harry48225/Octoscale/hardware/case.FCStd

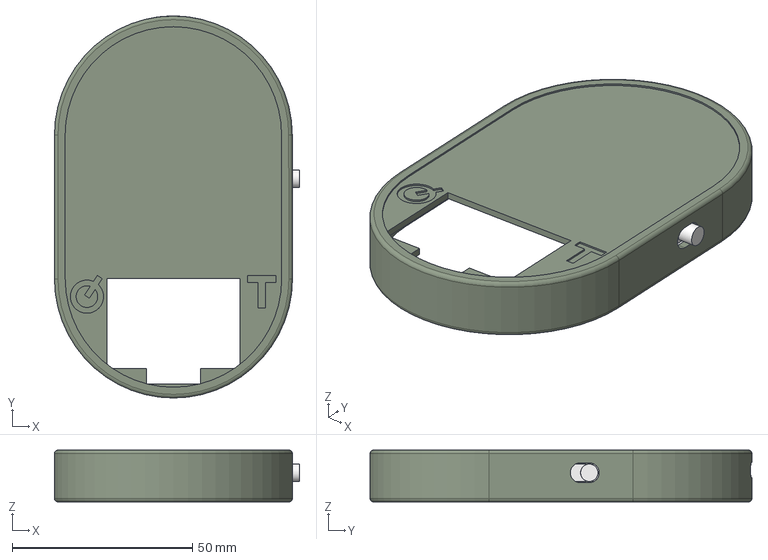
[picture p1: CAD file, 2022-09-23]
hardware/case.FCStd
68.0 x 106.0 x 14.4 mm
Case top
Slider
