harry48225/Octoscale/hardware/type-c-31-m-12-1.snapshot.5/HRO_TYPE-C-31-M-12.step

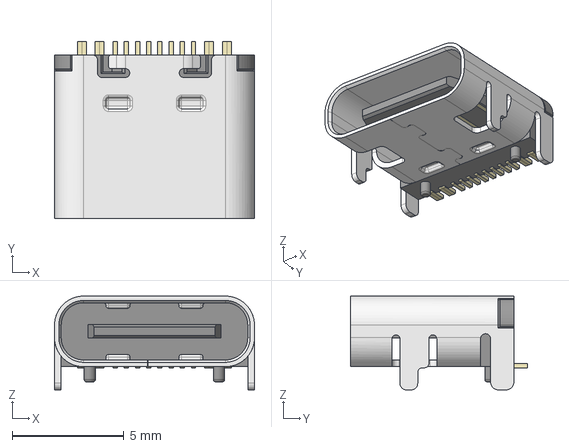
[picture p2: CAD file, 2022-06-12]
hardware/type-c-31-m-12-1.snapshot.5/HRO_TYPE-C-31-M-12.step
8.95 x 7.90 x 4.20 mm
