harry48225/Octoscale/hardware/500g load cell.FCStd

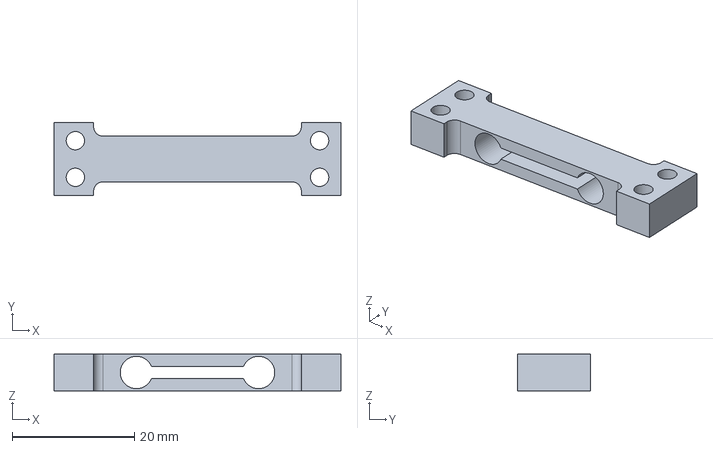
[picture p3: CAD file, 2022-06-10]
hardware/500g load cell.FCStd
47.0 x 12.0 x 6.00 mm
