harry48225/Octoscale/hardware/Battery pack.FCStd

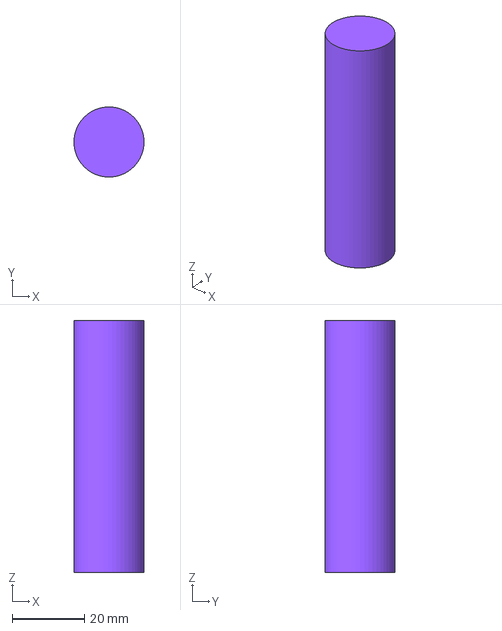
[picture p4: CAD file, 2022-06-09]
hardware/Battery pack.FCStd
19.5 x 19.5 x 70.0 mm
