harry48225/Octoscale/hardware/load cell-Body.step

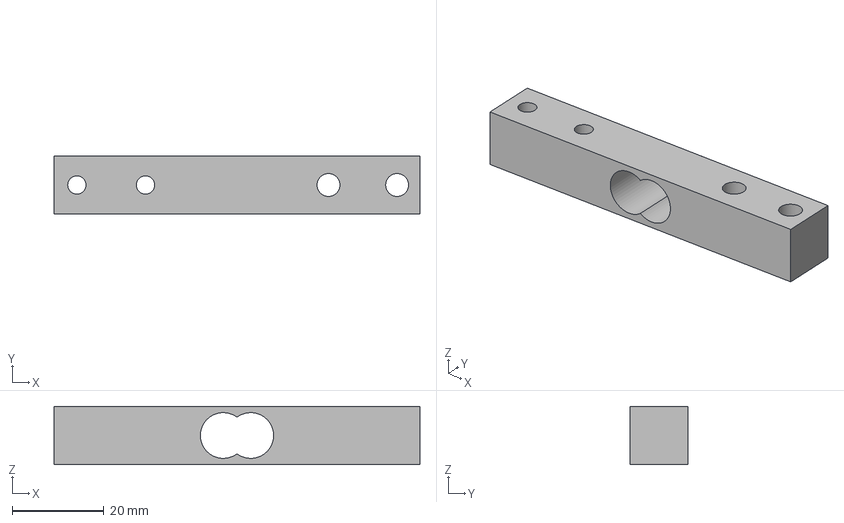
[picture p5: CAD file, 2022-06-09]
hardware/load cell-Body.step
80.0 x 12.7 x 12.7 mm
