harry48225/Octoscale/(list of files, cad)

Other CAD files:
hardware/Battery pack-Battery.step
hardware/load cell.FCStd
