harry48225/Octoscale/pcb/octoscale.kicad_pcb

## KiCad design pcb/octoscale.kicad_pcb (2022-11-08)

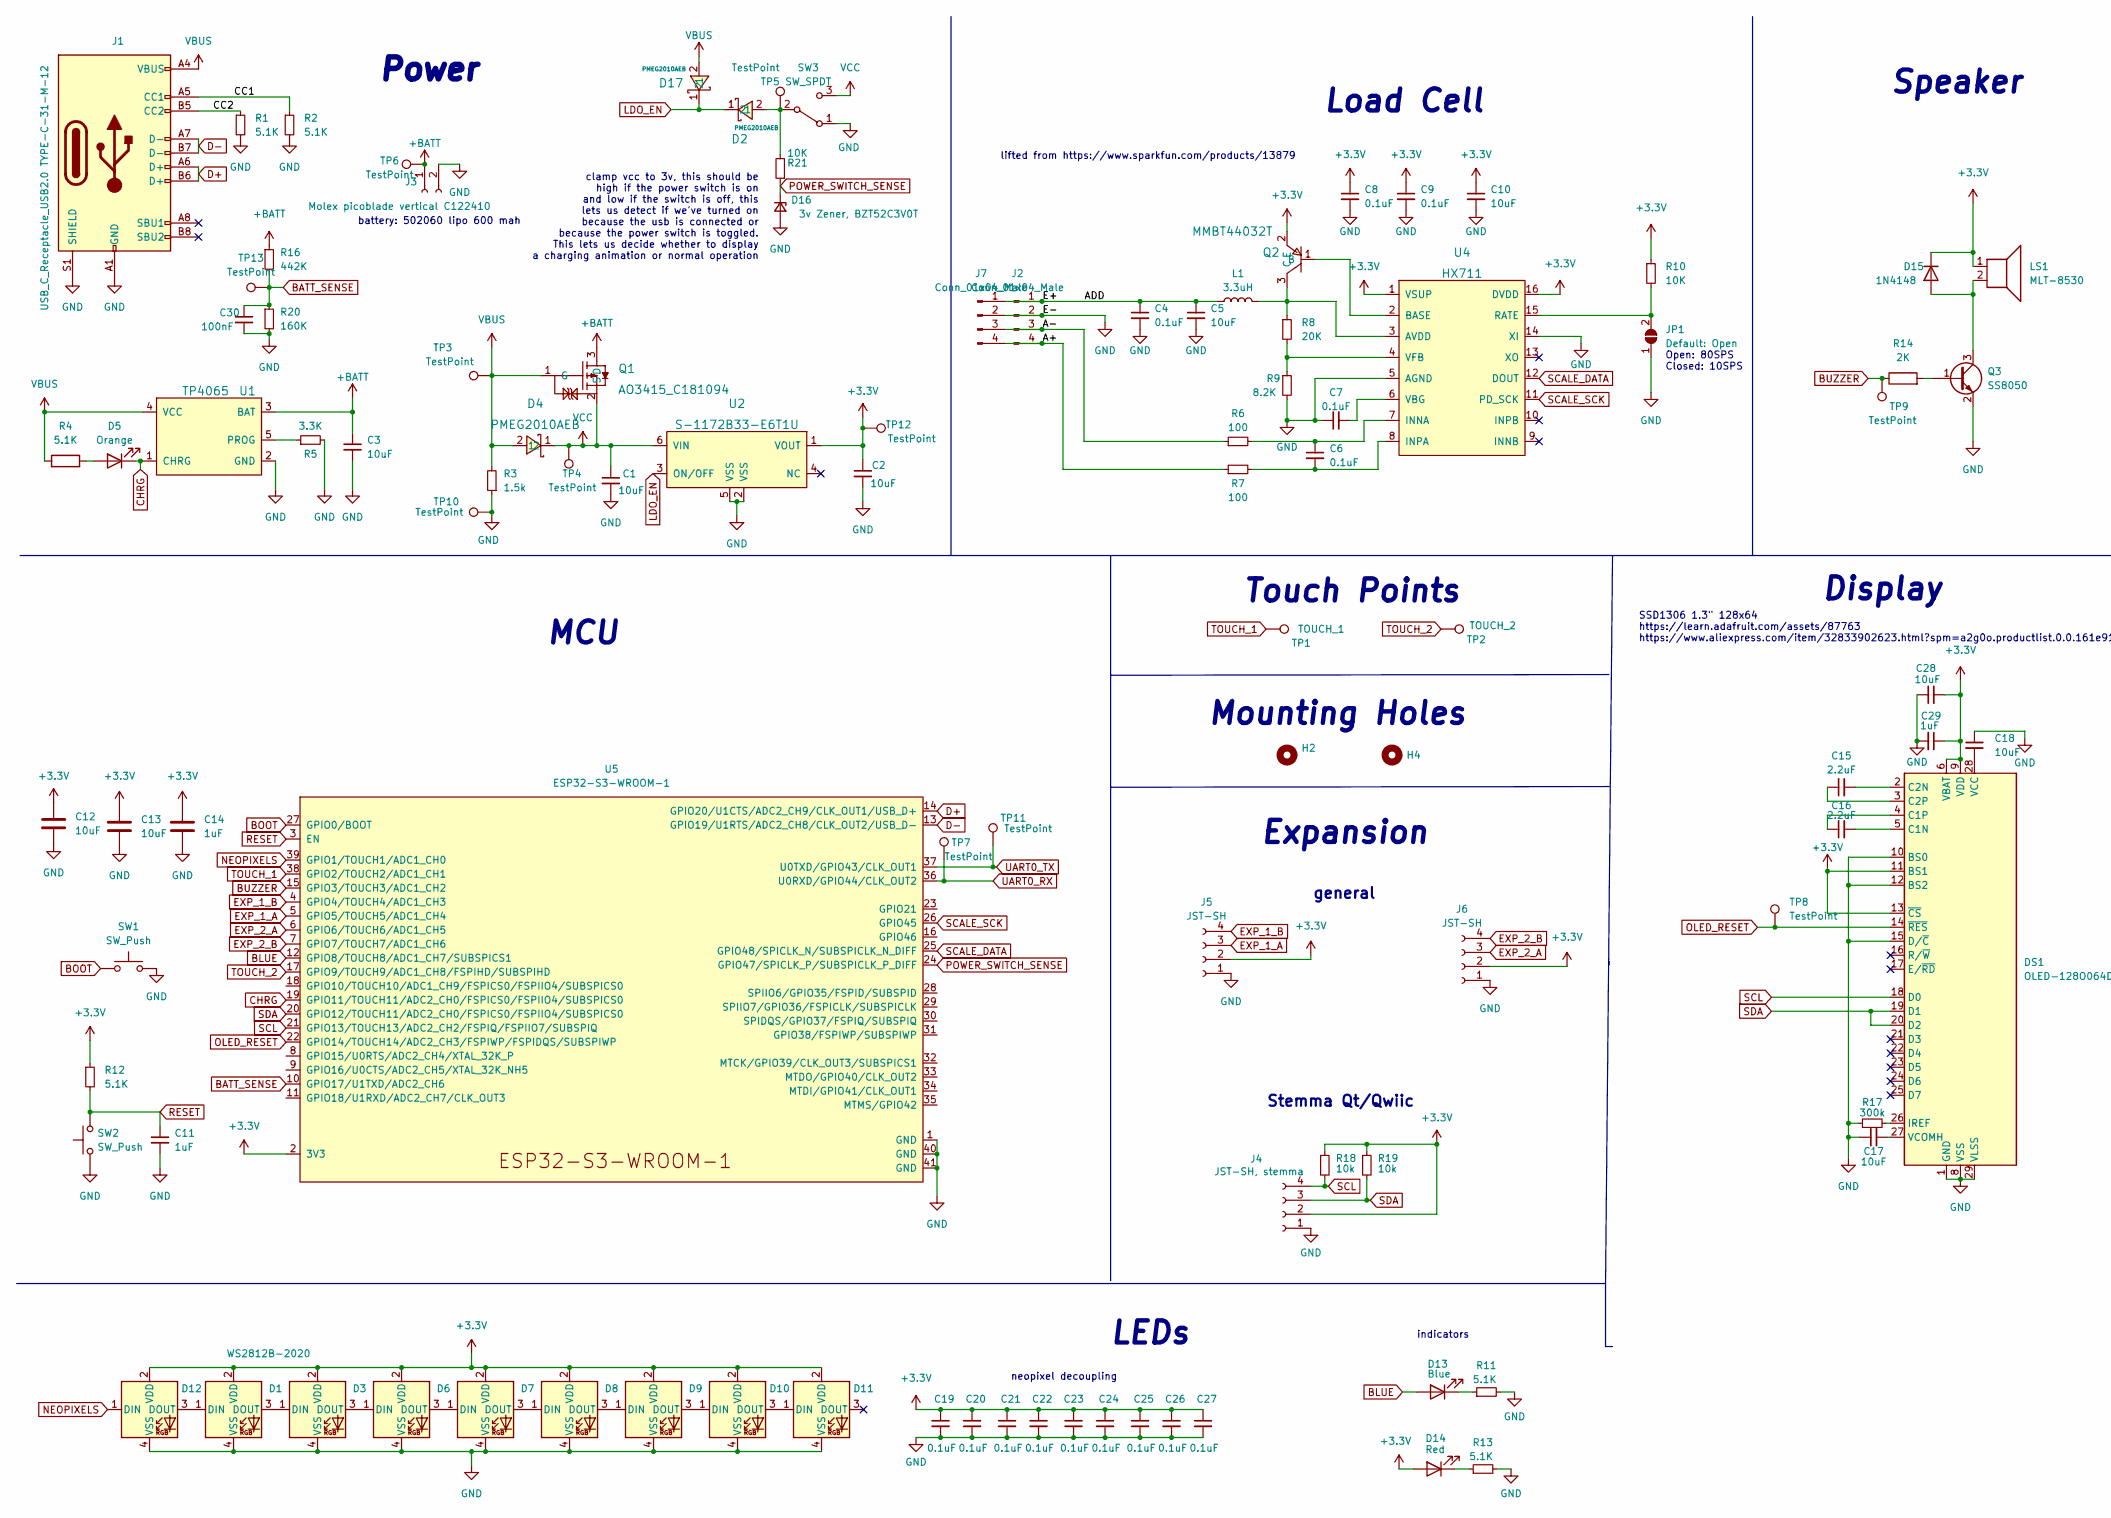
[picture p6: schematic octoscale.kicad_sch, part in row 1, column 1]

Parts:
C1, C2, C3, C5, C10, C12, C13, C17, C18, C28: 10uF; C_0805_2012Metric_Pad1.18x1.45mm_HandSolder
C4, C6, C7, C8, C9, C19, C20, C21, C22, C23, C24, C25, C26, C27: 0.1uF; C_0805_2012Metric_Pad1.18x1.45mm_HandSolder
C11, C14, C29: 1uF; C_0805_2012Metric_Pad1.18x1.45mm_HandSolder
C15, C16: 2.2uF; C_0805_2012Metric_Pad1.18x1.45mm_HandSolder
C30: 100nF; C_0805_2012Metric_Pad1.18x1.45mm_HandSolder
D1, D3, D6, D7, D8, D9, D10, D11, D12: WS2812B-2020; LED-SMD_4P-L2.0-W2.0-TL_WS2812B-2020
D2, D4, D17: PMEG2010AEB; D_SOD-523; LCSC Part C282563
D5: Orange; LED_0805_2012Metric_Pad1.15x1.40mm_HandSolder
D13: Blue; LED_0805_2012Metric_Pad1.15x1.40mm_HandSolder
D14: Red; LED_0805_2012Metric_Pad1.15x1.40mm_HandSolder
D15: 1N4148; D_SOD-323_HandSoldering
D16: 3v Zener, BZT52C3V0T; D_SOD-323
DS1: OLED-128O064D
H2, H4: MountingHole; MountingHole_2.7mm_M2.5
J1: USB_C_Receptacle_USB2.0 TYPE-C-31-M-12; USB-C_SMD-TYPE-C-31-M-12
J2, J7: Conn_01x04_Male; JST_SH_BM04B-SRSS-TB_1x04-1MP_P1.00mm_Vertical
J3: Molex picoblade vertical C122410; Molex_PicoBlade_53398-0271_1x02-1MP_P1.25mm_Vertical
J4: JST-SH, stemma; JST_SH_BM04B-SRSS-TB_1x04-1MP_P1.00mm_Vertical
J5, J6: JST-SH; JST_SH_BM04B-SRSS-TB_1x04-1MP_P1.00mm_Vertical
JP1: Default: Open; SolderJumper-2_P1.3mm_Open_TrianglePad1.0x1.5mm
L1: 3.3uH; L_0805_2012Metric_Pad1.05x1.20mm_HandSolder
LS1: MLT-8530; MagneticBuzzer_Kobitone_254-EMB84Q-RO
Q1: AO3415_C181094; SOT-23-3_L2.9-W1.3-P1.90-LS2.4-BR; LCSC Part C181094
Q2: MMBT44032T; SOT-23-3_L2.9-W1.3-P1.90-LS2.4-BR; LCSC Part C8513
Q3: SS8050; SOT-23
R1, R2, R4, R11, R12, R13: 5.1K; R_0805_2012Metric_Pad1.20x1.40mm_HandSolder
R3: 1.5k; R_0805_2012Metric_Pad1.20x1.40mm_HandSolder
R5: 3.3K; R_0805_2012Metric_Pad1.20x1.40mm_HandSolder
R6, R7: 100; R_0805_2012Metric_Pad1.20x1.40mm_HandSolder
R8: 20K; R_0805_2012Metric_Pad1.20x1.40mm_HandSolder
R9: 8.2K; R_0805_2012Metric_Pad1.20x1.40mm_HandSolder
R10, R21: 10K; R_0805_2012Metric_Pad1.20x1.40mm_HandSolder
R14: 2K; R_0805_2012Metric_Pad1.20x1.40mm_HandSolder
R16: 442K; R_0805_2012Metric_Pad1.20x1.40mm_HandSolder
R17: 300k; R_0805_2012Metric_Pad1.20x1.40mm_HandSolder
R18, R19: 10k; R_0805_2012Metric_Pad1.20x1.40mm_HandSolder
R20: 160K; R_0805_2012Metric_Pad1.20x1.40mm_HandSolder
SW1, SW2: SW_Push; SW_Push_1P1T_NO_CK_KMR2
SW3: SW_SPDT; SW_SPDT_PCM12
TP1: TOUCH_1; TouchPad
TP2: TOUCH_2; TouchPad
TP3, TP4, TP5, TP6, TP7, TP8, TP9, TP10, TP11, TP12, TP13: TestPoint; TestPoint_Pad_D1.5mm
U1: TP4065; SOT-23-5_L3.0-W1.7-P0.95-LS2.8-BR; LCSC Part C113540
U2: S-1172B33-E6T1U; HSOP-6_L5.0-W3.9-P1.91-LS6.0-BL; LCSC Part C140913
U4: HX711; SOP-16_L10.0-W3.9-P1.27-LS6.0-BL; LCSC Part C43656
U5: ESP32-S3-WROOM-1

Connections:
+3.3V: C2.1, C8.1, C9.1, C10.1, C12.1, C13.1, C14.1, C19.1, C20.1, C21.1, C22.1, C23.1, C24.1, C25.1, C26.1, C27.1, C28.2, C29.1, D1.2 (VDD), D3.2 (VDD), D6.2 (VDD), D7.2 (VDD), D8.2 (VDD), D9.2 (VDD), D10.2 (VDD), D11.2 (VDD), D12.2 (VDD), D14.2 (A), D15.1 (K), DS1.6 (VBAT), DS1.9 (VDD), DS1.11 (BS1), DS1.13 (~CS), J4.2, J5.2, J6.2, LS1.1, Q2.2 (E), R10.1, R12.1, R18.1, R19.1, TP12.1, U2.1 (VOUT), U4.1 (VSUP), U4.16 (DVDD), U5.2 (3V3)
+BATT: C3.1, J3.1, Q1.3 (D), R16.1, TP6.1, U1.3 (BAT)
/A+: J2.4, J7.4, R7.1
/A-: J2.3, J7.3, R6.1
/ADD: C4.1, C5.1, J2.1, J7.1, L1.1
/CC1: J1.A5 (CC1), R2.1
/CC2: J1.B5 (CC2), R1.1
BATT_SENSE: C30.1, R16.2, R20.1, TP13.1, U5.10 (GPIO17/U1TXD/ADC2_CH6)
BLUE: D13.2 (A), U5.12 (GPIO8/TOUCH8/ADC1_CH7/SUBSPICS1)
BOOT: SW1.1, U5.27 (GPIO0/BOOT)
BUZZER: R14.1, TP9.1, U5.15 (GPIO3/TOUCH3/ADC1_CH2)
CHRG: D5.1 (K), U1.1 (CHRG), U5.19 (GPIO11/TOUCH11/ADC2_CH0/FSPICS0/FSPIIO4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)
D+: J1.A6 (D+), J1.B6 (D+), U5.14 (GPIO20/U1CTS/ADC2_CH9/CLK_OUT1/USB_D+)
D-: J1.A7 (D-), J1.B7 (D-), U5.13 (GPIO19/U1RTS/ADC2_CH8/CLK_OUT2/USB_D-)
EXP_1_A: J5.3, U5.5 (GPIO5/TOUCH5/ADC1_CH4)
EXP_1_B: J5.4, U5.4 (GPIO4/TOUCH4/ADC1_CH3)
EXP_2_A: J6.3, U5.6 (GPIO6/TOUCH6/ADC1_CH5)
EXP_2_B: J6.4, U5.7 (GPIO7/TOUCH7/ADC1_CH6)
GND: C1.2, C2.2, C3.2, C4.2, C5.2, C7.1, C8.2, C9.2, C10.2, C11.2, C12.2, C13.2, C14.2, C17.1, C18.1, C19.2, C20.2, C21.2, C22.2, C23.2, C24.2, C25.2, C26.2, C27.2, C28.1, C29.2, C30.2, D1.4 (VSS), D3.4 (VSS), D6.4 (VSS), D7.4 (VSS), D8.4 (VSS), D9.4 (VSS), D10.4 (VSS), D11.4 (VSS), D12.4 (VSS), D16.2 (A), DS1.1 (GND), DS1.8 (VSS), DS1.10 (BS0), DS1.12 (BS2), DS1.15 (D/~C), DS1.29 (VLSS), DS1.30 (GND), J1.A1 (GND), J1.A12 (GND), J1.B1 (GND), J1.B12 (GND), J1.S1 (SHIELD), J2.2, J3.2, J4.1, J5.1, J6.1, J7.2, JP1.1 (A), Q3.2 (E), R1.2, R2.2, R3.1, R5.2, R9.2, R11.2, R13.2, R17.1, R20.2, SW1.2, SW2.1, SW3.1 (A), TP10.1, U1.2 (GND), U2.2 (VSS), U2.5 (VSS), U4.5 (AGND), U4.14 (XI), U5.1 (GND), U5.40 (GND), U5.41 (GND)
LDO_EN: D2.1, D17.1, U2.3 (ON/OFF)
NEOPIXELS: D12.1 (DIN), U5.39 (GPIO1/TOUCH1/ADC1_CH0)
unnamed: C6.1, R6.2, U4.7 (INNA)
unnamed: C6.2, R7.2, U4.8 (INPA)
unnamed: C7.2, U4.6 (VBG)
unnamed: C15.1, DS1.3 (C2P)
unnamed: C15.2, DS1.2 (C2N)
unnamed: C16.1, DS1.4 (C1P)
unnamed: C16.2, DS1.5 (C1N)
unnamed: C17.2, DS1.27 (VCOMH)
unnamed: C18.2, DS1.28 (VCC)
unnamed: D1.1 (DIN), D12.3 (DOUT)
unnamed: D1.3 (DOUT), D3.1 (DIN)
unnamed: D2.2, R21.2, SW3.2 (B), TP5.1
unnamed: D3.3 (DOUT), D6.1 (DIN)
unnamed: D5.2 (A), R4.2
unnamed: D6.3 (DOUT), D7.1 (DIN)
unnamed: D7.3 (DOUT), D8.1 (DIN)
unnamed: D8.3 (DOUT), D9.1 (DIN)
unnamed: D9.3 (DOUT), D10.1 (DIN)
unnamed: D10.3 (DOUT), D11.1 (DIN)
unnamed: D13.1 (K), R11.1
unnamed: D14.1 (K), R13.1
unnamed: D15.2 (A), LS1.2, Q3.3 (C)
unnamed: DS1.26 (IREF), R17.2
unnamed: JP1.2 (B), R10.2, U4.15 (RATE)
unnamed: L1.2, Q2.3 (C), R8.1, U4.3 (AVDD)
unnamed: Q2.1 (B), U4.2 (BASE)
unnamed: Q3.1 (B), R14.2
unnamed: R5.1, U1.5 (PROG)
unnamed: R8.2, R9.1, U4.4 (VFB)
OLED_RESET: DS1.14 (~RES), TP8.1, U5.22 (GPIO14/TOUCH14/ADC2_CH3/FSPIWP/FSPIDQS/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)
POWER_SWITCH_SENSE: D16.1 (K), R21.1, U5.24 (GPIO47/SPICLK_P/SUBSPICLK_P_DIFF)
RESET: C11.1, R12.2, SW2.2, U5.3 (EN)
SCALE_DATA: U4.12 (DOUT), U5.25 (GPIO48/SPICLK_N/SUBSPICLK_N_DIFF)
SCALE_SCK: U4.11 (PD_SCK), U5.26 (GPIO45)
SCL: DS1.18 (D0), J4.4, R18.2, U5.21 (GPIO13/TOUCH13/ADC2_CH2/FSPIQ/FSPIIO7/S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)
SDA: DS1.19 (D1), DS1.20 (D2), J4.3, R19.2, U5.20 (GPIO12/TOUCH11/ADC2_CH0/FSPICS0/FSPIIO4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)
TOUCH_1: TP1.1, U5.38 (GPIO2/TOUCH2/ADC1_CH1)
TOUCH_2: TP2.1, U5.17 (GPIO9/TOUCH9/ADC1_CH8/FSPIHD/SUBSPIHD)
UART0_RX: TP7.1, U5.36 (U0RXD/GPIO44/CLK_OUT2)
UART0_TX: TP11.1, U5.37 (U0TXD/GPIO43/CLK_OUT1)
VBUS: D4.2, D17.2, J1.A4 (VBUS), J1.A9 (VBUS), J1.B4 (VBUS), J1.B9 (VBUS), Q1.1 (G), R3.2, R4.1, TP3.1, U1.4 (VCC)
VCC: C1.1, D4.1, Q1.2 (S), SW3.3 (C), TP4.1, U2.6 (VIN)

Notes on the sheet:
lifted from https://www.sparkfun.com/products/13879
Open: 80SPS Closed: 10SPS
Touch Points
MCU
Power
battery: 502060 lipo 600 mah
Display
Expansion
Mounting Holes
SSD1306 1.3" 128x64 https://learn.adafruit.com/assets/87763 https://www.aliexpress.com/item/32833902623.html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…
clamp vcc to 3v, this should be high if the power switch is on and low if the switch is off, this lets us detect if we've turned on because the usb is connected or because the power switch is toggled. This lets us decide whether to display a charging animation or normal operation
Stemma Qt/Qwiic
LEDs
Speaker
Load Cell
neopixel decoupling
general
indicators

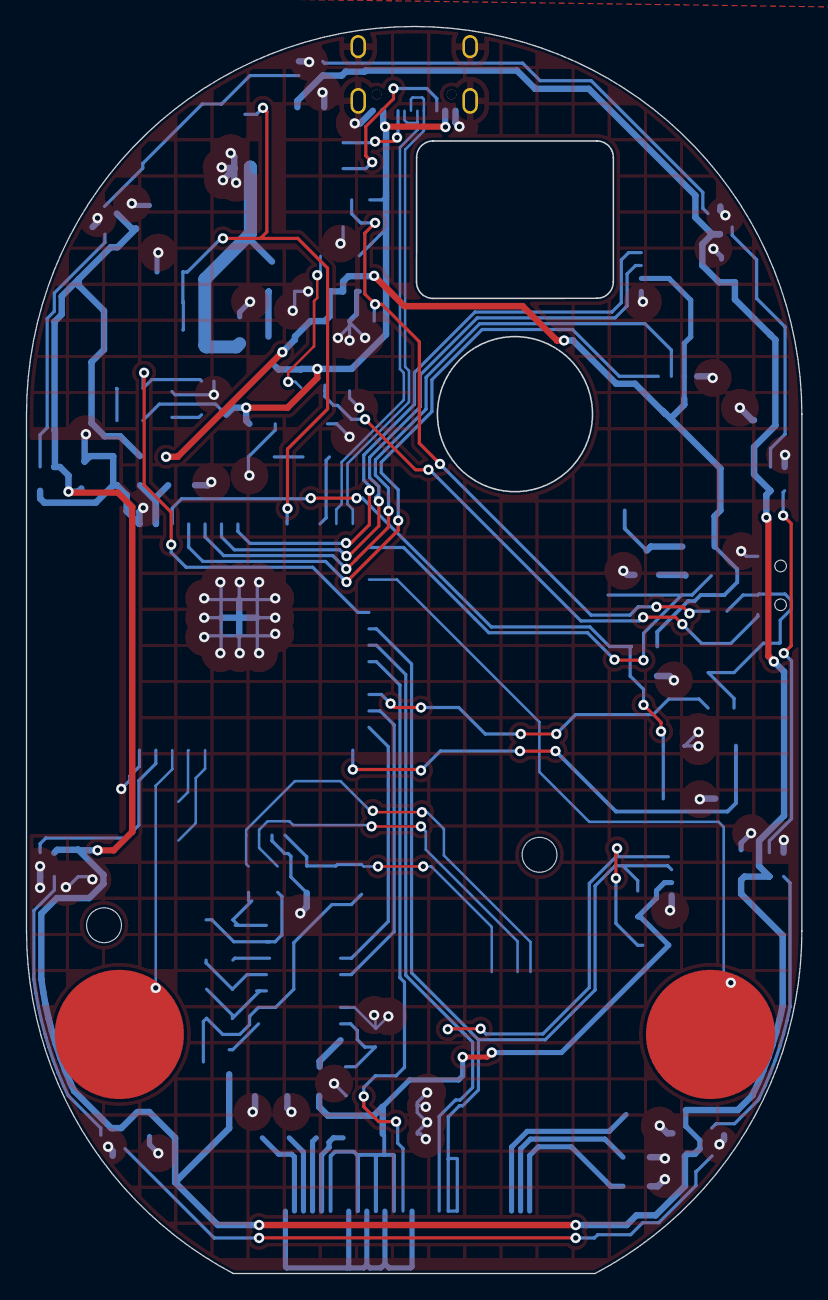
[picture p7: board octoscale.kicad_pcb from above]

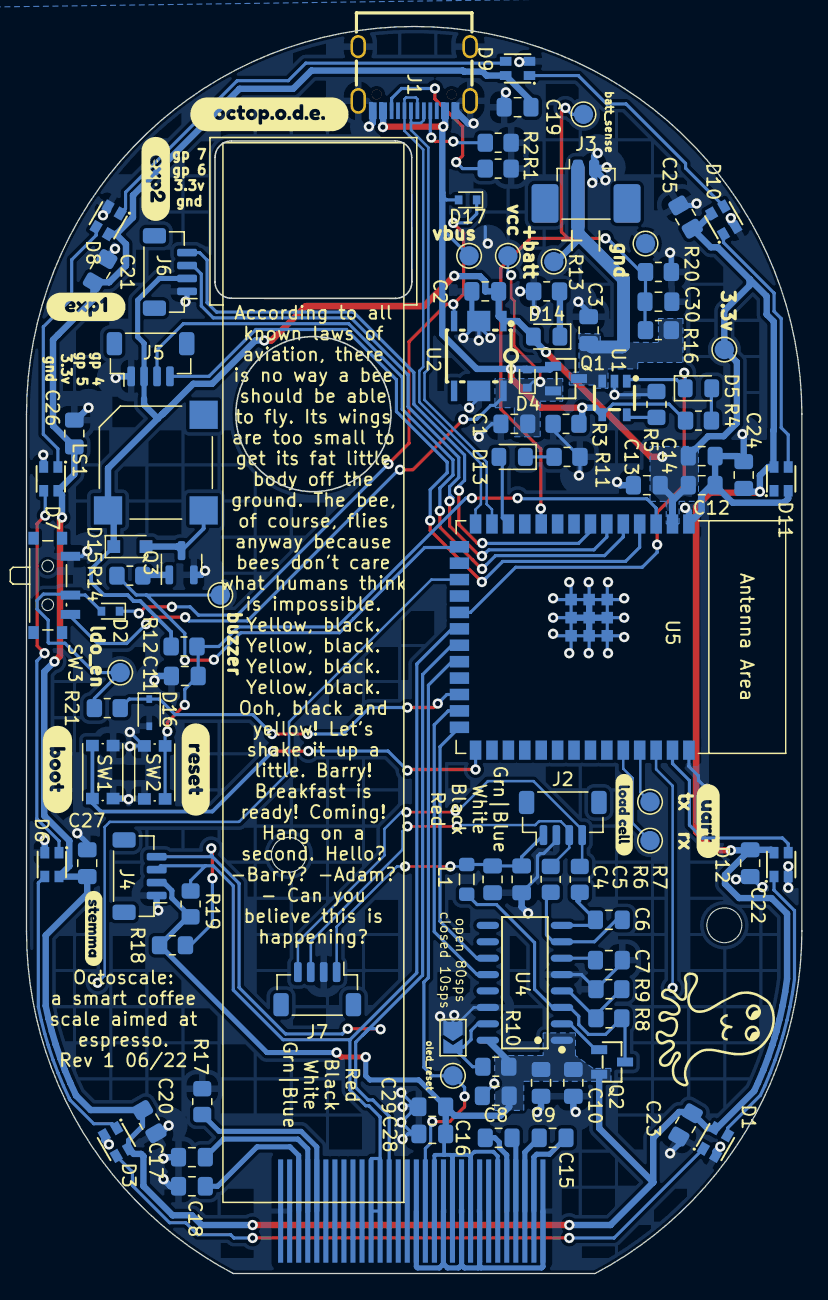
[picture p8: board octoscale.kicad_pcb from below]

Board: 2 copper layers, 60.0 x 96.5 mm, 111 parts (107 on the bottom side), 63 nets.

Other parts of the board:
kibuzzard-62A1FF38: G***; kibuzzard-62A1FF38
kibuzzard-629CD677: G***; kibuzzard-629CD677
kibuzzard-629CD693: G***; kibuzzard-629CD693
kibuzzard-629CDB8B: G***; kibuzzard-629CDB8B
kibuzzard-629CE03A: G***; kibuzzard-629CE03A
kibuzzard-629E3B4E: G***; kibuzzard-629E3B4E
kibuzzard-629E3B7C: G***; kibuzzard-629E3B7C
kibuzzard-629E3091: G***; kibuzzard-629E3091
