harry48225/Octoscale/firmware/src/animations.h

namespace Animations {
  namespace Tare {
    void reset();
    void update();
  }

  namespace Charging {
    void reset();
    void update();
  }

  namespace Charged {
    void reset();
    void update();
  }
}
