harry48225/Octoscale/(commit log)

2022-05-08 Improve calibration routine
2022-05-08 Add 1 euro filter
2022-05-15 Convert timer to mins and seconds
2022-05-17 Make graph track brew weight
2022-05-29 Refactor timer
2022-05-29 stop graph when timer primed
2022-06-01 Add timer duration characteristic
2022-06-02 Add timer duration to app
2022-06-02 Improve timer styling
2022-06-02 Show timer only when timing
2022-06-09 consolidate files
    [B2B-PH-SM4-TB.STEP, BM04B-SRSS-TB.STEP, CUI_DEVICES_CPT-9019S-SMT-TR.step, KMR243GLFG.stp, PCB v8.step, before art.kicad_pcb, octoscale.csv, octoscale.kicad_pcb]
2022-06-09 Model load cell
    [case.FCStd, load cell.FCStd]
2022-06-09 Add battery
    [Battery pack-Battery.step, Battery pack.FCStd, case.FCStd, load cell-Body.step]
2022-06-09 Try different battery sizes
    [case.FCStd]
2022-06-09 Move load cell
    [octoscale.kicad_pcb]
2022-06-09 Move battery connector
    [case.FCStd, octoscale.kicad_pcb]
2022-06-09 first draft of case
    [case.FCStd, octoscale.kicad_pcb, octoscale.kicad_sch]
2022-06-09 add lipo cavity
    [case.FCStd]
2022-06-10 Swap load cell
    [500g load cell-500g Load cell.step, 500g load cell.FCStd, case.FCStd]
2022-06-12 Decrease ble power usage by ~33%
2022-06-12 Fix calibration routine
2022-06-12 Change battery connector and load cell
    [B2B-PH-SM4-TB.STEP, BM04B-SRSS-TB.STEP, CUI_DEVICES_CPT-9019S-SMT-TR.step, KMR243GLFG.stp, PCB v8.step, before art.kicad_pcb, case.FCStd, octoscale (copy).kicad_pcb]
2022-06-12 Bottom of case
    [B2B-PH-SM4-TB.STEP, BM04B-SRSS-TB.STEP, CUI_DEVICES_CPT-9019S-SMT-TR.step, KMR243GLFG.stp, PCB v8.step, before art.kicad_pcb, case.FCStd, octoscale (copy).kicad_pcb]
2022-06-12 Add load cell mounting to top
    [case.FCStd]
2022-06-12 Add usb c port
    [HRO_TYPE-C-31-M-12.step, case.FCStd]
2022-06-12 Tweak height clearance
    [case.FCStd, octoscale.kicad_sch]
2022-06-22 Change oled to ssd1306 and fix hx711 agnd
    [octoscale.kicad_pcb, octoscale.kicad_sch]
2022-06-22 Minor tweaks
    [case.FCStd]
2022-06-22 Move touch 2 pins
    [octoscale.kicad_pcb, octoscale.kicad_sch]
2022-06-22 Add charge detection
2022-06-22 Remove ground fill from under esp32
    [octoscale.kicad_pcb]
2022-06-22 Add batt_sense test point
    [octoscale.kicad_pcb, octoscale.kicad_sch]
2022-06-22 tweak batt sense silk
    [octoscale.kicad_pcb]
2022-06-26 Tweak to layout and power ldo en
    [octoscale.kicad_pcb, octoscale.kicad_sch]
2022-06-26 Tweak charging speed
    [octoscale.kicad_pcb, octoscale.kicad_sch]
2022-06-26 Move Batt sense to adc capable pin
    [octoscale.kicad_pcb, octoscale.kicad_sch]
2022-06-27 Change zener footprint
    [octoscale.csv, octoscale.kicad_pcb, octoscale.kicad_sch]
2022-06-28 Fix neopixel footprint
    [octoscale.kicad_pcb, octoscale.kicad_sch]
2022-06-30 Slight tweaks
    [octoscale.kicad_pcb, octoscale.kicad_sch]
2022-07-03 Add snail graphic
    [octoscale.kicad_sch]
2022-07-03 Generate gerbers
    [octoscale-B_Cu.gbl, octoscale-B_Mask.gbs, octoscale-B_Paste.gbp, octoscale-B_Silkscreen.gbo, octoscale-Edge_Cuts.gm1, octoscale-F_Cu.gtl, octoscale-F_Mask.gts, octoscale-F_Paste.gtp]
2022-07-04 pcb tweaks
2022-07-05 Add action buttons to settings
2022-08-05 Misc pcb changes
2022-08-07 Refactor action buttons
2022-08-29 Add top mounting holes
    [case.FCStd]
2022-08-29 reduce acrylic thickness
    [case.FCStd]
2022-08-30 Increase toggle length
    [case.FCStd]
2022-08-30 generate bom
2022-08-30 increase slider length
    [case.FCStd]
2022-08-30 Fix slider placement
    [case.FCStd]
2022-08-30 more slider tweaks
    [case.FCStd]
2022-08-30 Small tweaks
    [case.FCStd]
2022-08-31 Initial tweaks to get working on pcb
2022-08-31 Add embedded nuts
    [case.FCStd]
2022-09-01 Adjust lcd mounting
    [case.FCStd]
2022-09-01 add display cut out
    [case.FCStd]
2022-09-01 basic touch buttons
2022-09-02 Improve button handling
2022-09-02 Enlarge oled cut out
    [case.FCStd]
2022-09-02 model window
    [case.FCStd]
2022-09-02 increase window tolerance
    [case.FCStd]
2022-09-02 tweak button sensitivity
2022-09-02 add led button feedback
2022-09-03 tune filter
2022-09-04 remove window
    [case.FCStd]
2022-09-04 add captive window
    [case.FCStd]
2022-09-04 tweak window
    [case.FCStd]
2022-09-04 change display cut out
    [case.FCStd]
2022-09-04 change fillet
    [case.FCStd]
2022-09-04 enlarge holes
    [case.FCStd]
2022-09-04 tune button
2022-09-04 improve timer priming
2022-09-04 add mass to timer screen
2022-09-04 add ability to cancel timer when primed
2022-09-06 improve button senstivity
2022-09-06 improve timer behaviour
2022-09-06 improve timer
2022-09-06 refactor buttons code
2022-09-06 fix led bug
2022-09-06 adjust slider
    [case.FCStd]
2022-09-06 case tweaks
    [case.FCStd]
2022-09-07 fix power on bug
    [buttons.cpp]
2022-09-09 improve button handlng
2022-09-09 fix touch sensor bug
    [buttons.cpp]
2022-09-09 add icons for touch target
    [case.FCStd]
2022-09-10 improve start timer conditions
2022-09-10 improve timer countdown
2022-09-14 add bluetooth buttons
2022-09-14 fix not enough handles
    [bluetooth.cpp]
2022-09-15 tweak buttons
2022-09-15 update buttons
2022-09-15 fix some graph jitter
2022-09-23 Add timer
2022-09-23 sandwich acrylic more
    [case.FCStd]
2022-09-23 add battery sprites
2022-09-23 add battery voltage sensing
2022-09-23 return charge level
2022-09-23 add charging detection
2022-09-24 improve charging dectection
2022-09-24 add power switch sense
2022-09-24 add charging and sleeping state
2022-09-24 add charging animation
2022-09-24 add charging screen
2022-09-26 add sleep charged state
2022-09-26 remove charging screen
2022-09-27 dont hide timer
2022-09-27 fix battery icon bug
    [display.cpp]
2022-09-28 improve battery monitoring
2022-09-28 remove voltage display
2022-09-30 only show battery warning when power on
2022-11-01 basic schematic and pcb changes
    [octoscale.kicad_pcb, octoscale.kicad_sch]
2022-11-03 fix speaker transistor
    [octoscale.kicad_pcb, octoscale.kicad_sch]
2022-11-03 Fix buzzer footprint
    [octoscale.kicad_pcb, octoscale.kicad_sch]
2022-11-08 Fix drc errors
    [octoscale.kicad_pcb, octoscale.kicad_sch]
2022-11-08 generate gerbers and update revision number
    [octoscale-B_Cu.gbl, octoscale-B_Mask.gbs, octoscale-B_Paste.gbp, octoscale-B_Silkscreen.gbo, octoscale-Edge_Cuts.gm1, octoscale-F_Cu.gtl, octoscale-F_Mask.gts, octoscale-F_Paste.gtp]
